sharpdad/mod-emup-usb/hardware/fab/bom.csv

Reference | Value | Footprint
A1 | Arduino Nano (5 V) | Module:Arduino_Nano
C1 | 100u 25V | Capacitor_THT:CP_Radial_D8.0mm_P3.50mm
C2 | 220u 10V | Capacitor_THT:CP_Radial_D8.0mm_P3.50mm
C3 | 47u 25V | Capacitor_THT:CP_Radial_D6.3mm_P2.50mm
C4 | 100n | Capacitor_THT:C_Disc_D5.0mm_W2.5mm_P5.00mm
C5 | 100n | Capacitor_THT:C_Disc_D5.0mm_W2.5mm_P5.00mm
D1 | 1N5822 (reverse protection) | Diode_THT:D_DO-201AD_P15.24mm_Horizontal
D2 | LED (+5 V on) | LED_THT:LED_D3.0mm
J1 | 12 V DC in (2.1 mm, centre +) | Connector_BarrelJack:BarrelJack_Horizontal
J2 | DB25 female (to the MOD-EMUP box) | Connector_Dsub:DSUB-25_Female_Horizontal_P2.77x2.84mm_EdgePinOffset14.56mm_Housed_MountingHolesOffset15.98mm
R1 | 10k | Resistor_THT:R_Axial_DIN0207_L6.3mm_D2.5mm_P10.16mm_Horizontal
R2 | 10k | Resistor_THT:R_Axial_DIN0207_L6.3mm_D2.5mm_P10.16mm_Horizontal
R3 | 10k | Resistor_THT:R_Axial_DIN0207_L6.3mm_D2.5mm_P10.16mm_Horizontal
R4 | 10k | Resistor_THT:R_Axial_DIN0207_L6.3mm_D2.5mm_P10.16mm_Horizontal
R5 | 1k | Resistor_THT:R_Axial_DIN0207_L6.3mm_D2.5mm_P10.16mm_Horizontal
U1 | RECOM R-78B5.0-2.0 | Converter_DCDC:Converter_DCDC_RECOM_R-78B-2.0_THT
U2 | TRACO TMR 1-1211 (-12 V: +out to GND) | Converter_DCDC:Converter_DCDC_TRACO_TMR-1-xxxx_Single_THT
U3 | 74HCT245 | Package_DIP:DIP-20_W7.62mm_Socket
U4 | 74HCT244 | Package_DIP:DIP-20_W7.62mm_Socket
