sharpdad/mod-emup-usb/hardware/emup_adapter.pdf

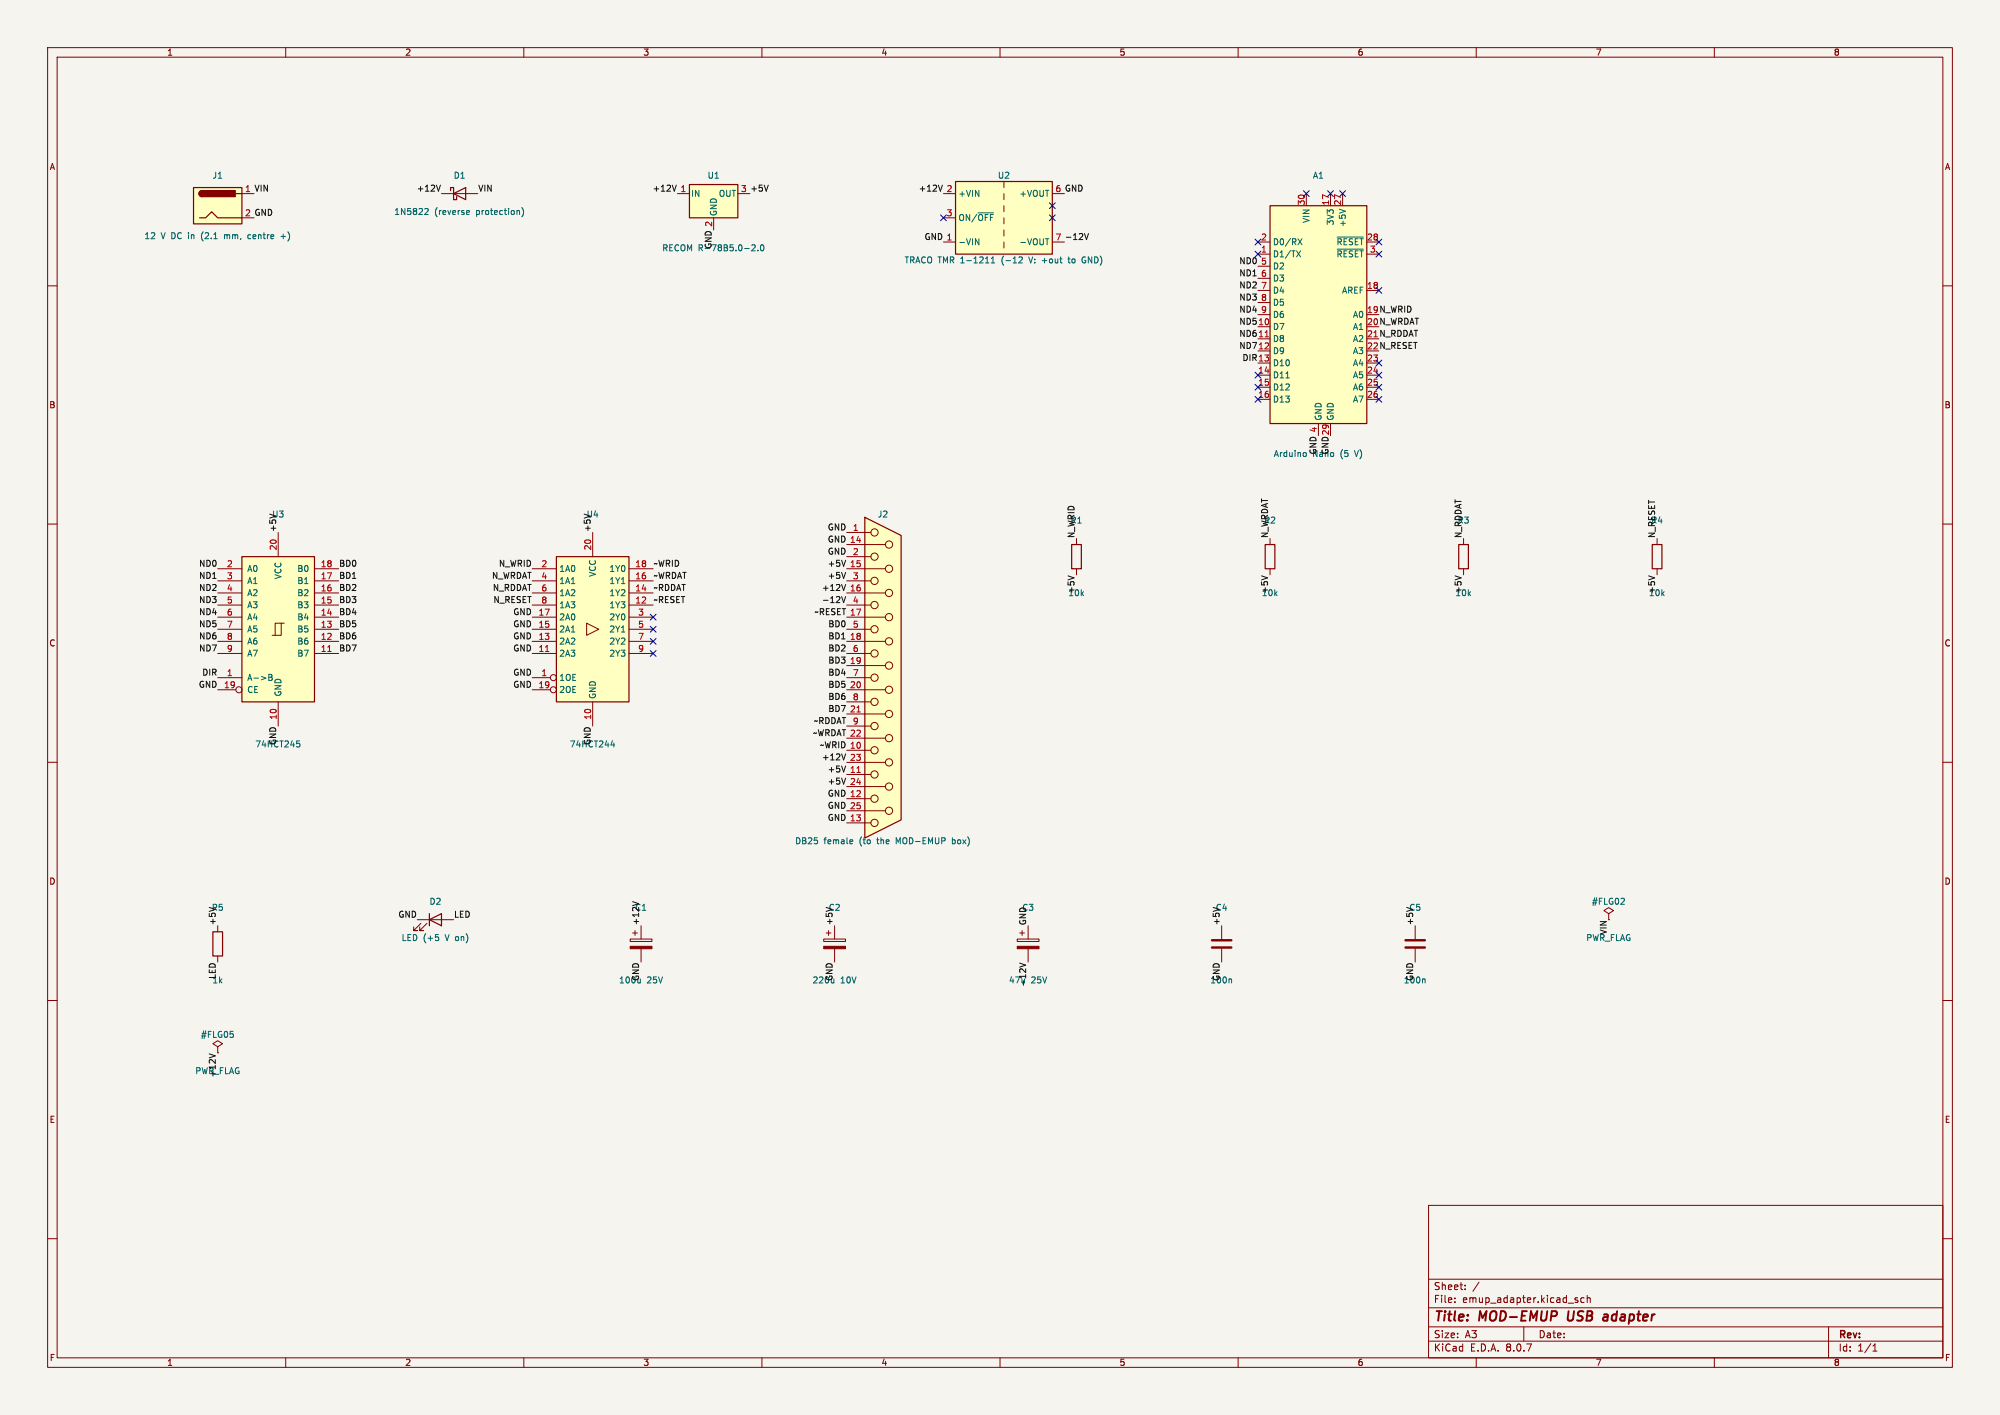
[picture p2: page 1]

12 V DC in (2.1 mm, centre +)

Id: 1/1 Title: MOD-EMUP USB adapter File: emup_adapter.kicad_sch Sheet: / C4
