sharpdad/mod-emup-usb/hardware/emup_adapter.kicad_pcb

## KiCad design hardware/emup_adapter.kicad_pcb (2026-10-06)

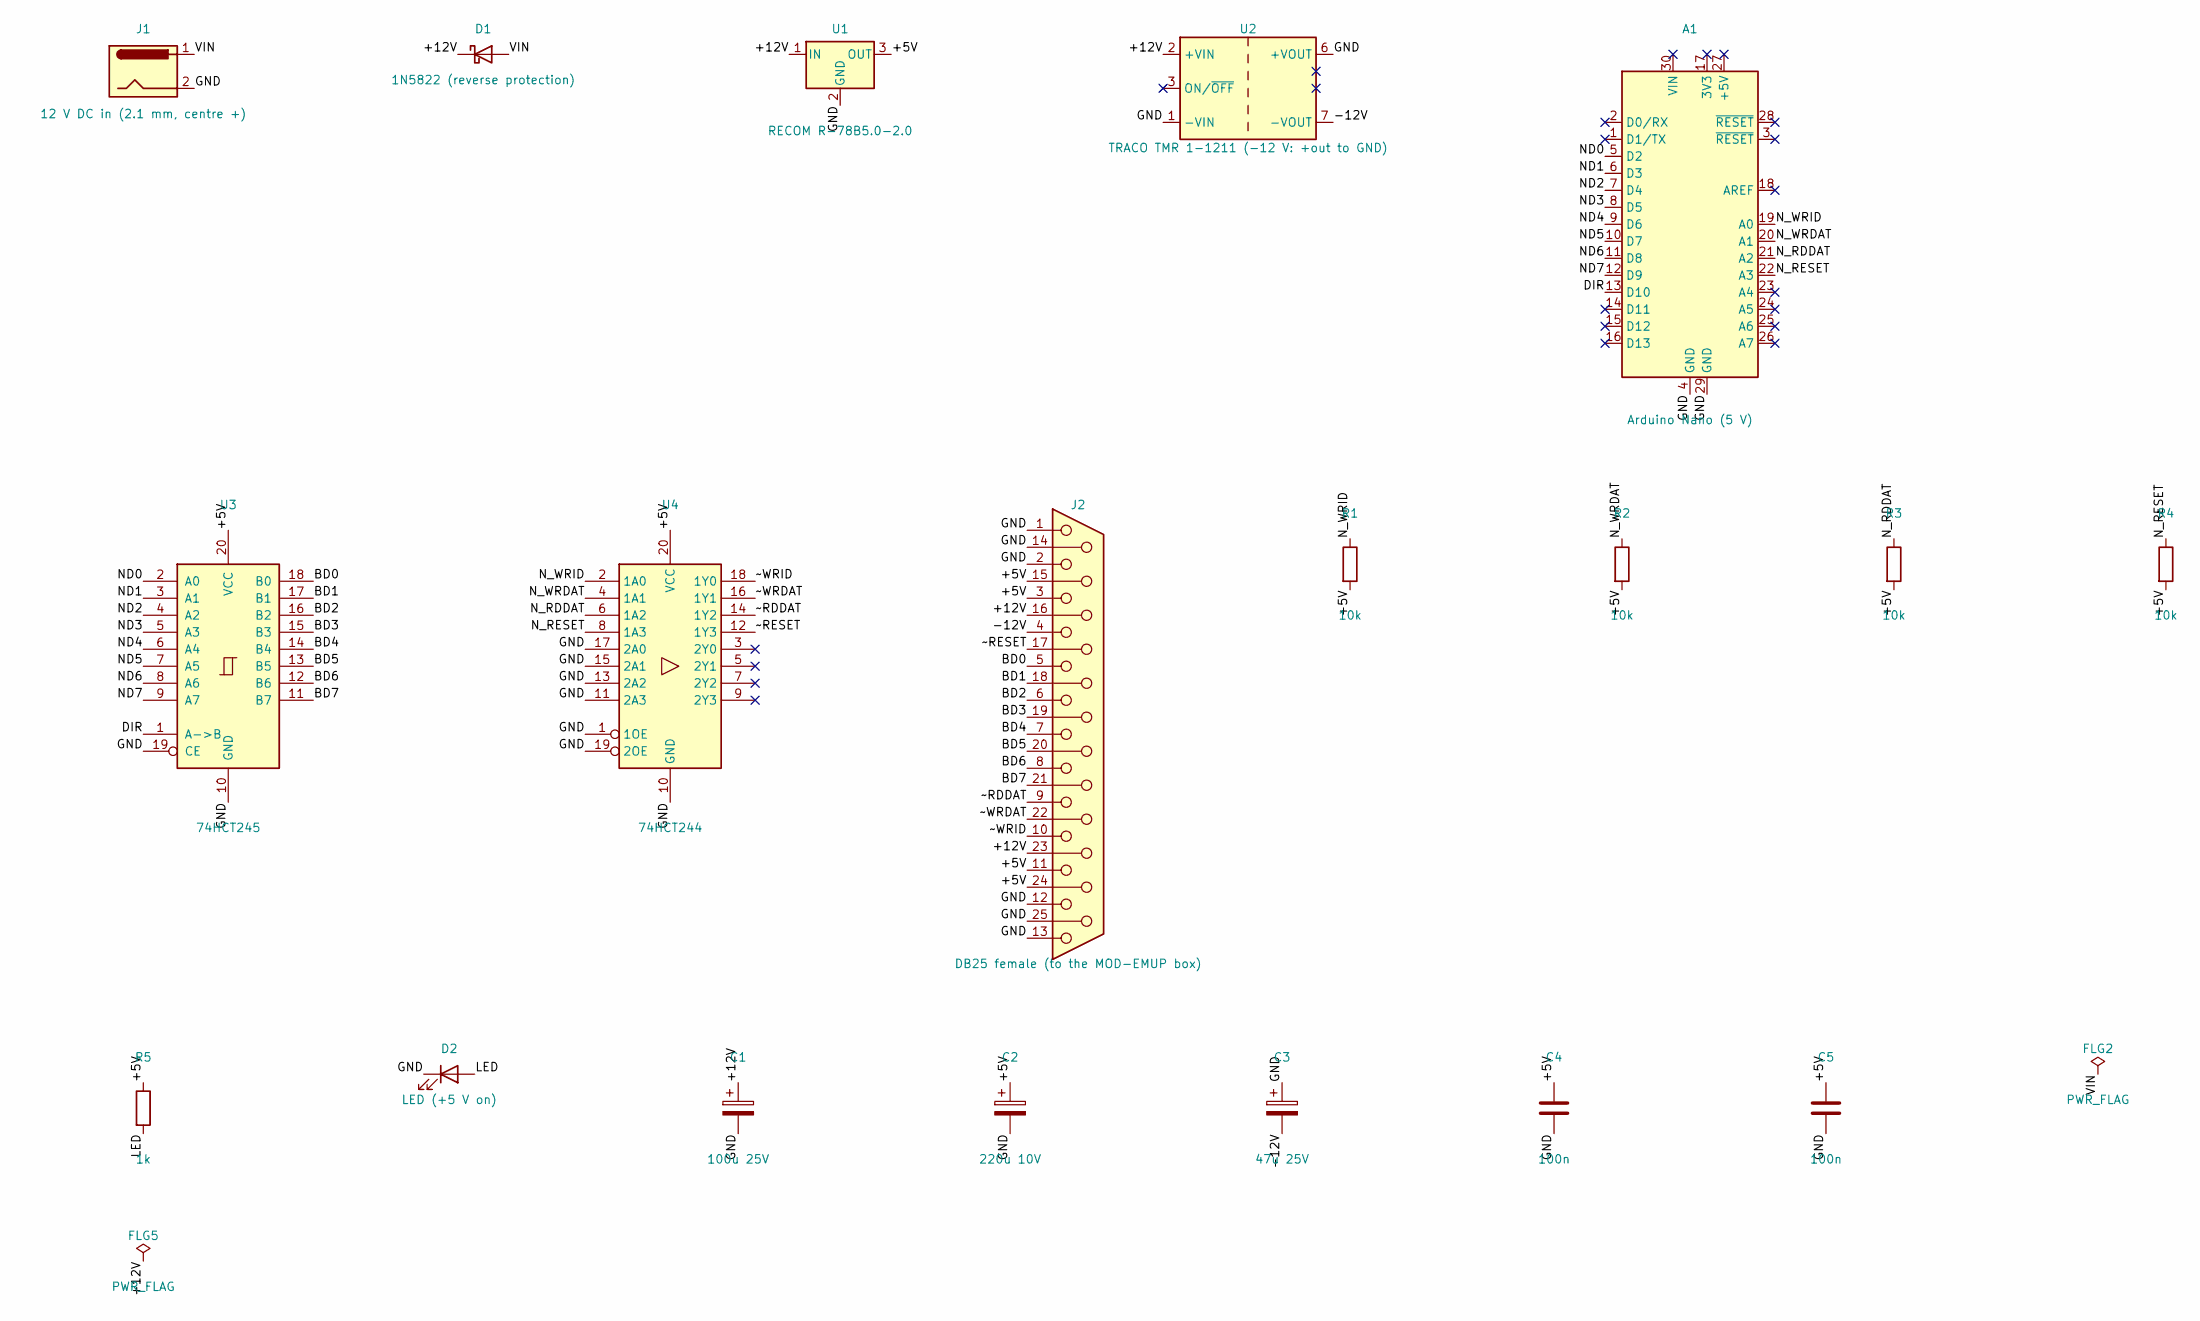
[picture p3: schematic emup_adapter.kicad_sch, MOD-EMUP USB adapter]

Parts:
A1: Arduino Nano (5 V); Arduino_Nano
C1: 100u 25V; CP_Radial_D8.0mm_P3.50mm
C2: 220u 10V; CP_Radial_D8.0mm_P3.50mm
C3: 47u 25V; CP_Radial_D6.3mm_P2.50mm
C4, C5: 100n; C_Disc_D5.0mm_W2.5mm_P5.00mm
D1: 1N5822 (reverse protection); D_DO-201AD_P15.24mm_Horizontal
D2: LED (+5 V on); LED_D3.0mm
FLG2, FLG5: PWR_FLAG
J1: 12 V DC in (2.1 mm, centre +); BarrelJack_Horizontal
J2: DB25 female (to the MOD-EMUP box); DSUB-25_Female_Horizontal_P2.77x2.84mm_EdgePinOffset14.56mm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
R1, R2, R3, R4: 10k; R_Axial_DIN0207_L6.3mm_D2.5mm_P10.16mm_Horizontal
R5: 1k; R_Axial_DIN0207_L6.3mm_D2.5mm_P10.16mm_Horizontal
U1: RECOM R-78B5.0-2.0; Converter_DCDC_RECOM_R-78B-2.0_THT
U2: TRACO TMR 1-1211 (-12 V: +out to GND); Converter_DCDC_TRACO_TMR-1-xxxx_Single_THT
U3: 74HCT245; DIP-20_W7.62mm_Socket
U4: 74HCT244; DIP-20_W7.62mm_Socket

Connections:
+5V: C2.1, C4.1, C5.1, J2.3, J2.11, J2.15, J2.24, R1.2, R2.2, R3.2, R4.2, R5.1, U1.3 (OUT), U3.20 (VCC), U4.20 (VCC)
+12V: C1.1, D1.1 (K), FLG5.1, J2.16, J2.23, U1.1 (IN), U2.2 (+VIN)
-12V: C3.2, J2.4, U2.7 (-VOUT)
BD0: J2.5, U3.18 (B0)
BD1: J2.18, U3.17 (B1)
BD2: J2.6, U3.16 (B2)
BD3: J2.19, U3.15 (B3)
BD4: J2.7, U3.14 (B4)
BD5: J2.20, U3.13 (B5)
BD6: J2.8, U3.12 (B6)
BD7: J2.21, U3.11 (B7)
DIR: A1.13 (D10), U3.1 (A->B)
GND: A1.4 (GND), A1.29 (GND), C1.2, C2.2, C3.1, C4.2, C5.2, D2.1 (K), J1.2, J2.1, J2.2, J2.12, J2.13, J2.14, J2.25, U1.2 (GND), U2.1 (-VIN), U2.6 (+VOUT), U3.10 (GND), U3.19 (CE), U4.1 (1OE), U4.10 (GND), U4.11 (2A3), U4.13 (2A2), U4.15 (2A1), U4.17 (2A0), U4.19 (2OE)
LED: D2.2 (A), R5.2
ND0: A1.5 (D2), U3.2 (A0)
ND1: A1.6 (D3), U3.3 (A1)
ND2: A1.7 (D4), U3.4 (A2)
ND3: A1.8 (D5), U3.5 (A3)
ND4: A1.9 (D6), U3.6 (A4)
ND5: A1.10 (D7), U3.7 (A5)
ND6: A1.11 (D8), U3.8 (A6)
ND7: A1.12 (D9), U3.9 (A7)
N_RDDAT: A1.21 (A2), R3.1, U4.6 (1A2)
N_RESET: A1.22 (A3), R4.1, U4.8 (1A3)
N_WRDAT: A1.20 (A1), R2.1, U4.4 (1A1)
N_WRID: A1.19 (A0), R1.1, U4.2 (1A0)
VIN: D1.2 (A), FLG2.1, J1.1
~RDDAT: J2.9, U4.14 (1Y2)
~RESET: J2.17, U4.12 (1Y3)
~WRDAT: J2.22, U4.16 (1Y1)
~WRID: J2.10, U4.18 (1Y0)

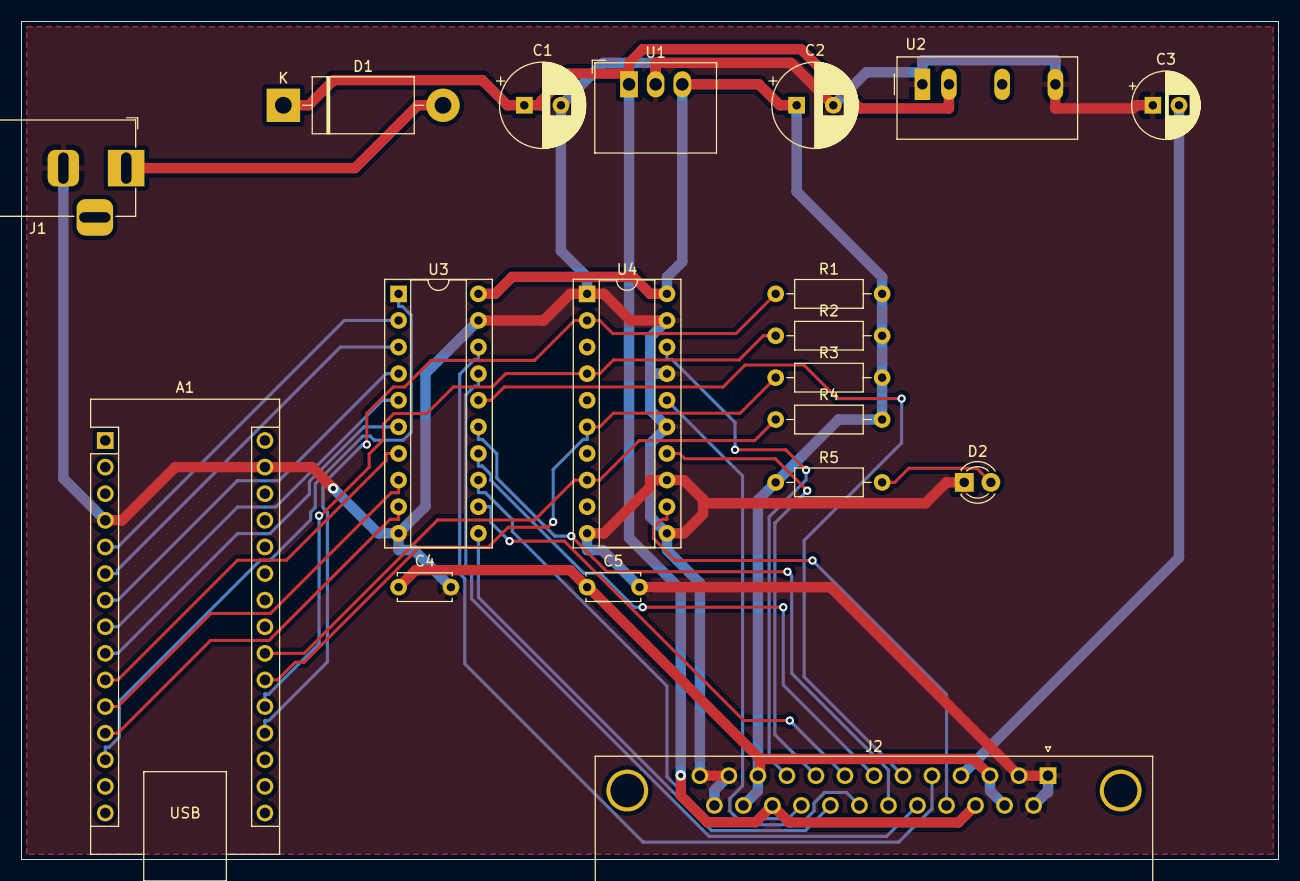
[picture p4: board emup_adapter.kicad_pcb from above]

Board: 2 copper layers, 120.0 x 80.0 mm, 19 parts (0 on the bottom side), 31 nets.
